citizendialogkitproject/citizen-dialog-kit/casing/CTA-large-background.pdf

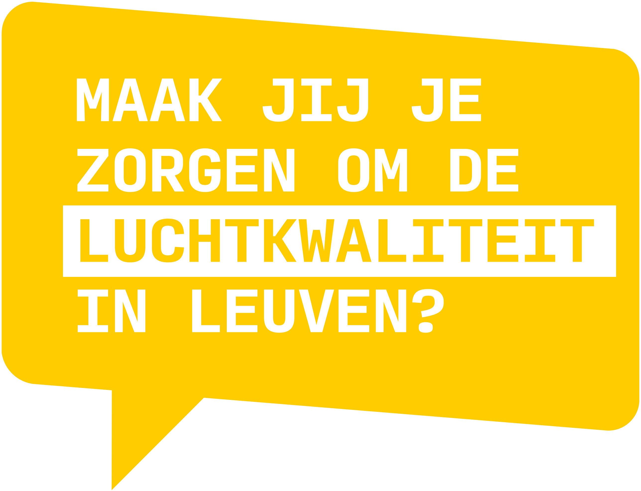
[picture p1: figure]
MAAK JIJ JE ZORGEN OM DE LUCHTKWALITEIT IN LEUVEN?
