citizendialogkitproject/citizen-dialog-kit/server/web/www/design/images/blank.png

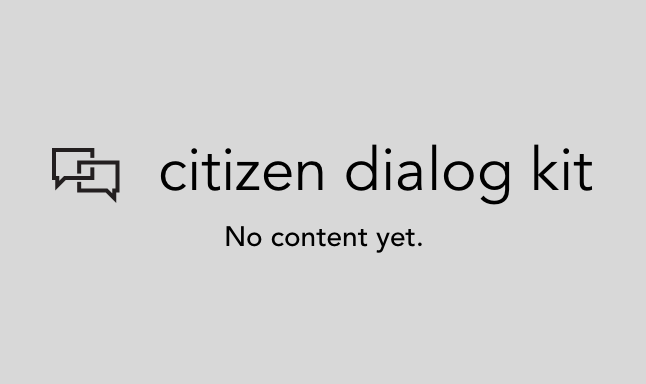
server/web/www/design/images/blank.png
