citizendialogkitproject/citizen-dialog-kit/server/web/www/design/images/rect1.png

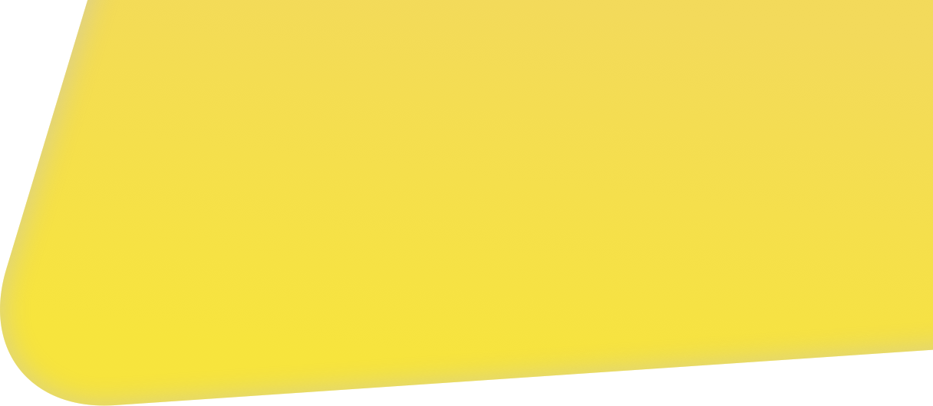
server/web/www/design/images/rect1.png
