citizendialogkitproject/citizen-dialog-kit/server/tests/data/test_640x384.png

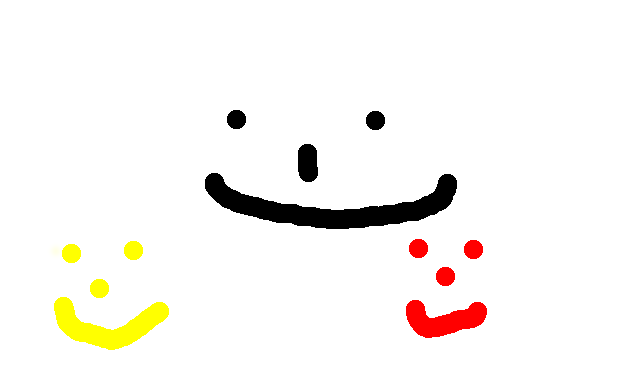
server/tests/data/test_640x384.png
