citizendialogkitproject/citizen-dialog-kit/casing/data-background.pdf

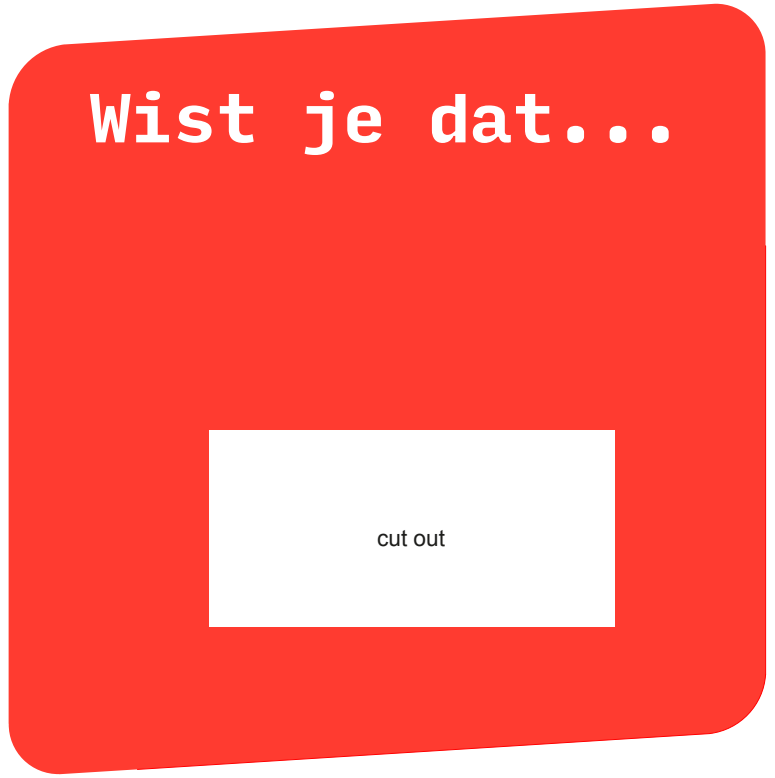
[picture p5: page 1]
cut out

Wist je dat...
