citizendialogkitproject/citizen-dialog-kit/casing/CTA-small-background.pdf

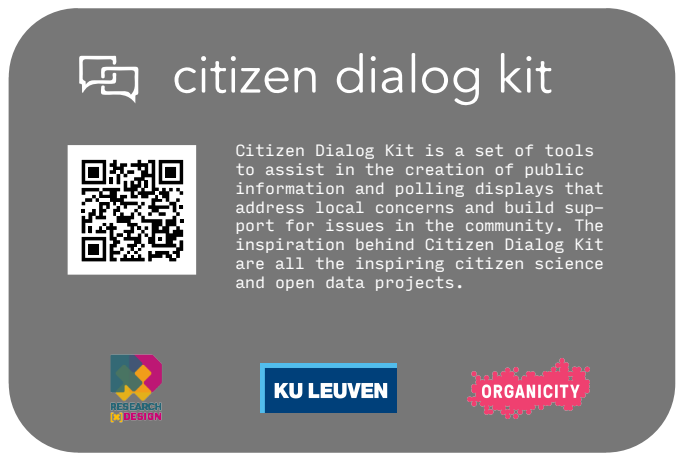
[picture p6: page 1]

Citizen Dialog Kit is a set of tools
to assist in the creation of public
information and polling displays that
address local concerns and build sup-
port for issues in the community. The
inspiration behind Citizen Dialog Kit
are all the inspiring citizen science
and open data projects.
