citizendialogkitproject/citizen-dialog-kit/casing/interactive-background.pdf

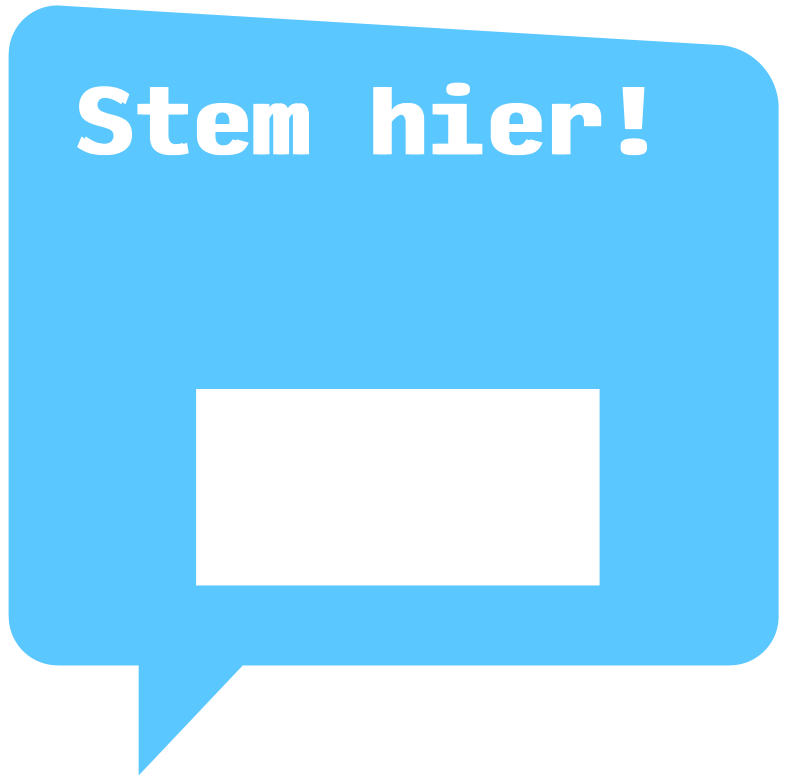
[picture p7: page 1]

Stem hier!
