citizendialogkitproject/citizen-dialog-kit/casing/plexi_layers6-Background8mm.pdf

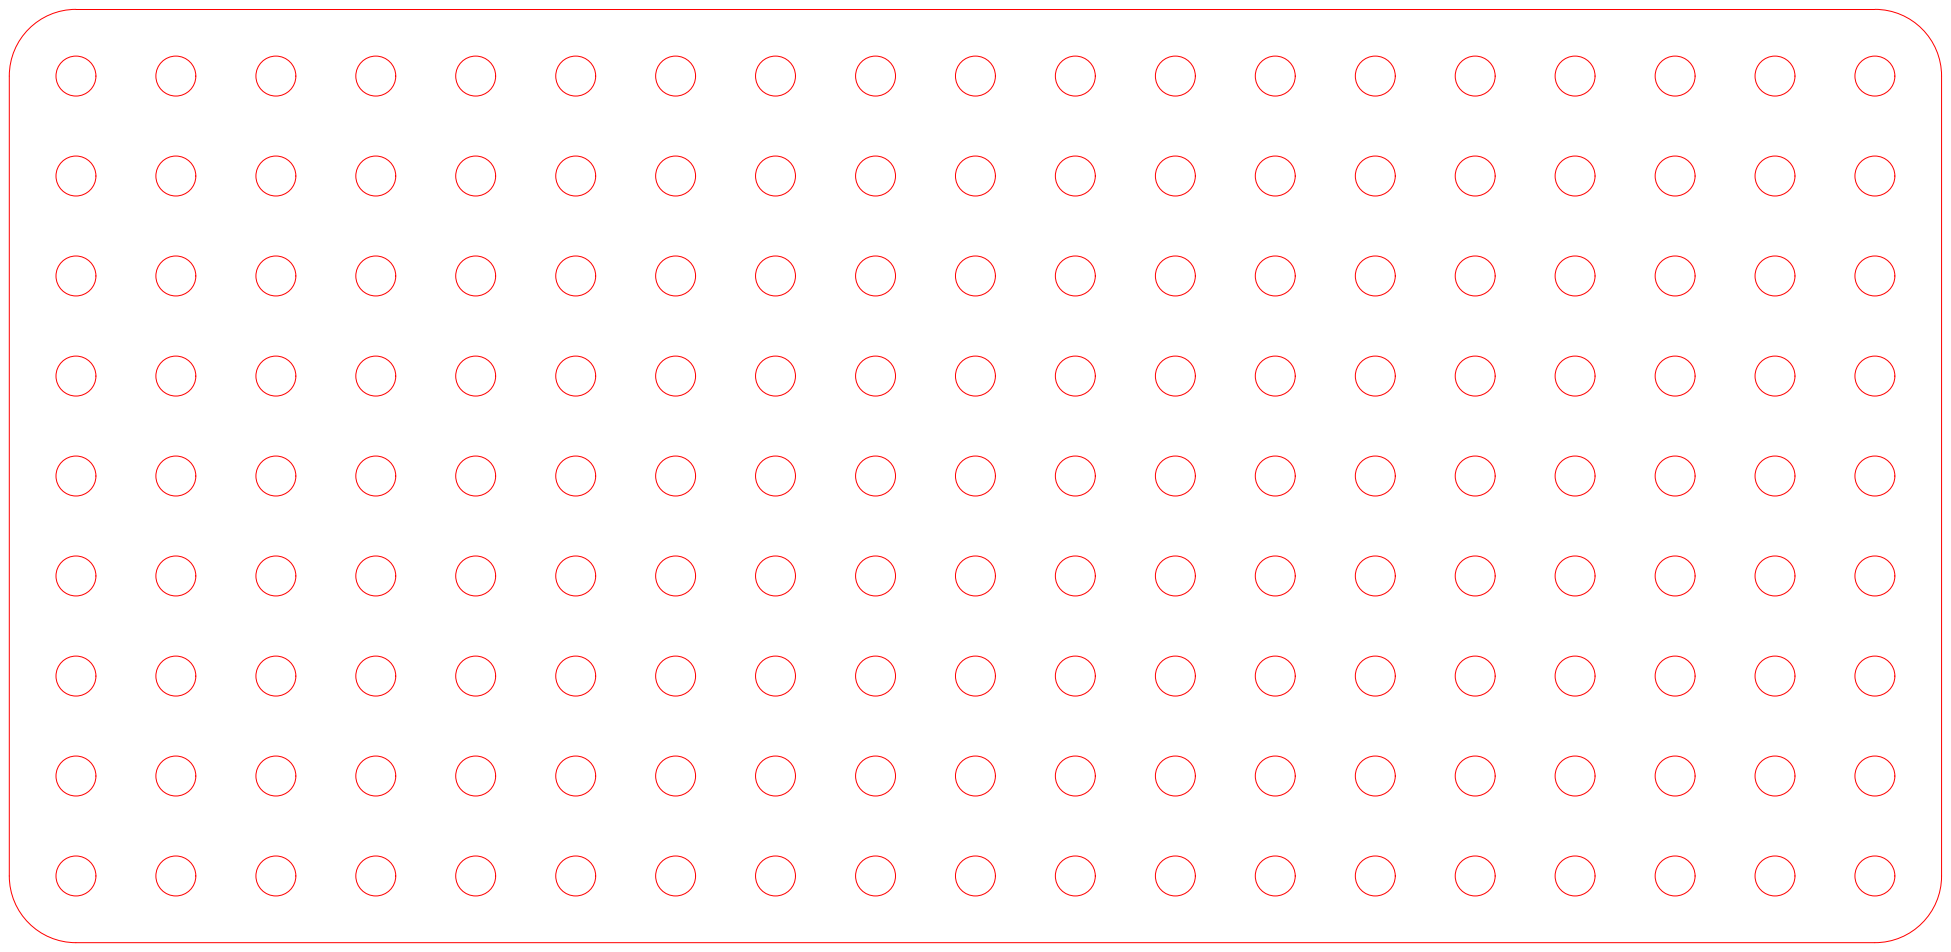
[picture p8: page 1]
