citizendialogkitproject/citizen-dialog-kit/casing/plexi_layers6-CTA2mm.pdf

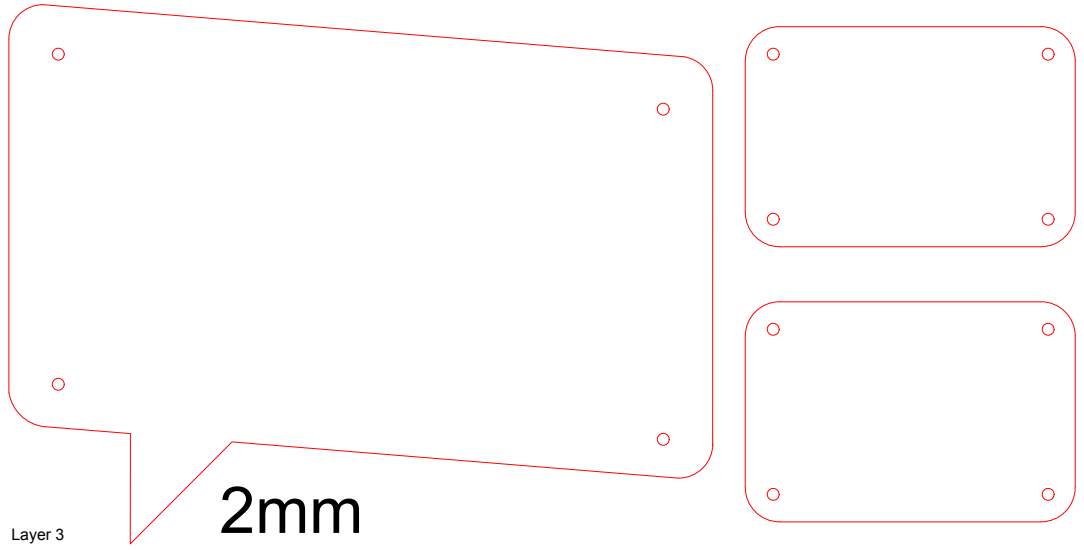
[picture p9: page 1]
Layer 3
