citizendialogkitproject/citizen-dialog-kit/casing/plexi_layers6-CTA2mmExtra.pdf

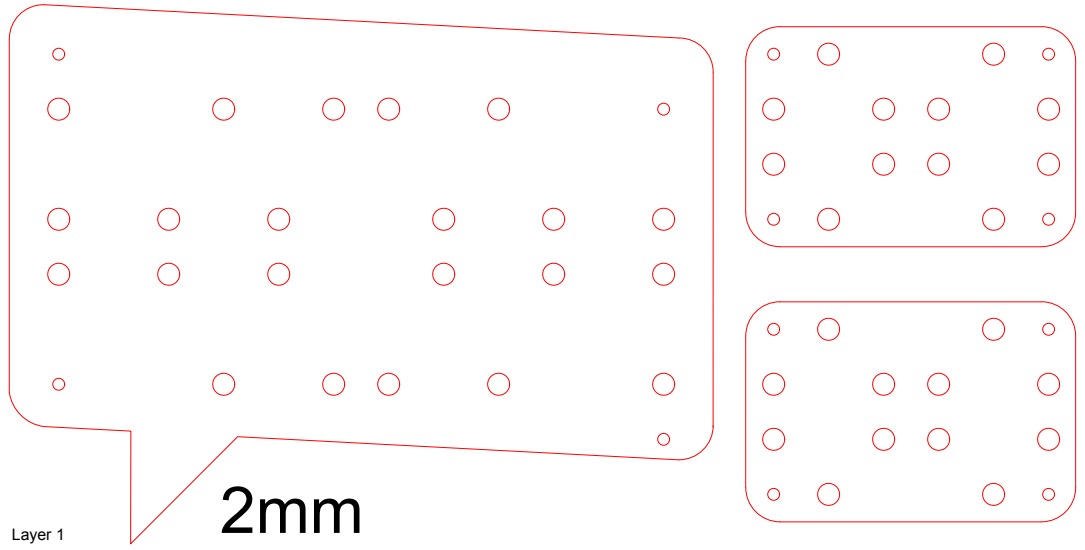
[picture p10: page 1]
Layer 1
