citizendialogkitproject/citizen-dialog-kit/casing/plexi_layers6-CTA8mm.pdf

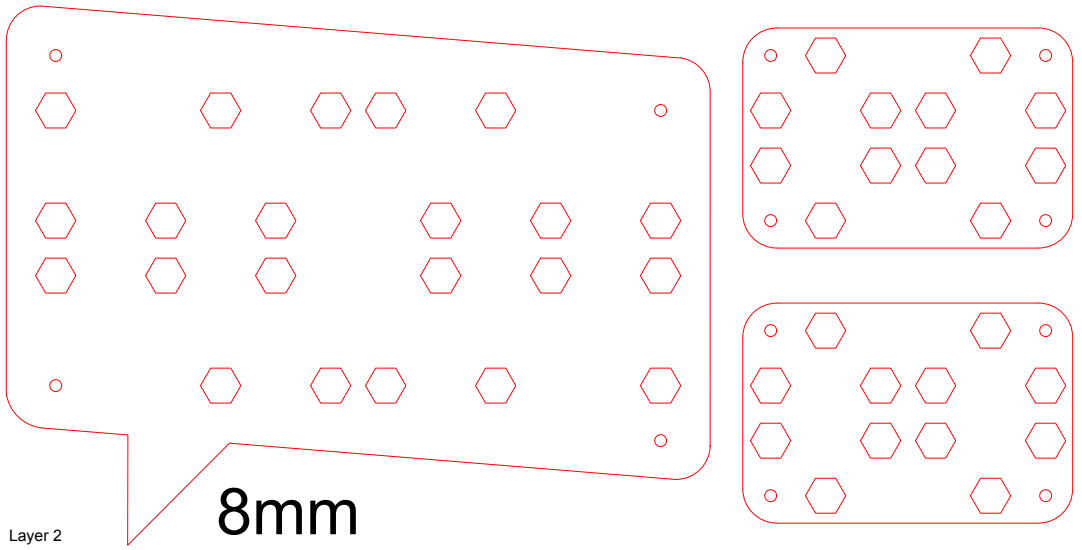
[picture p11: page 1]
Layer 2
