citizendialogkitproject/citizen-dialog-kit/casing/plexi_layers6-data2mm.pdf

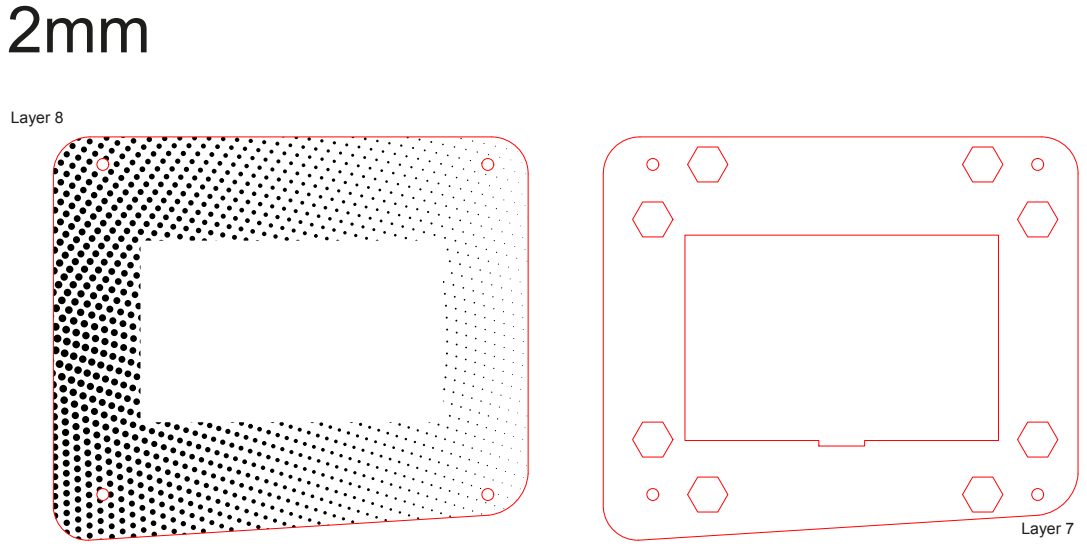
[picture p12: page 1]
Layer 7; Layer 8
