citizendialogkitproject/citizen-dialog-kit/casing/plexi_layers6-data2mm2.pdf

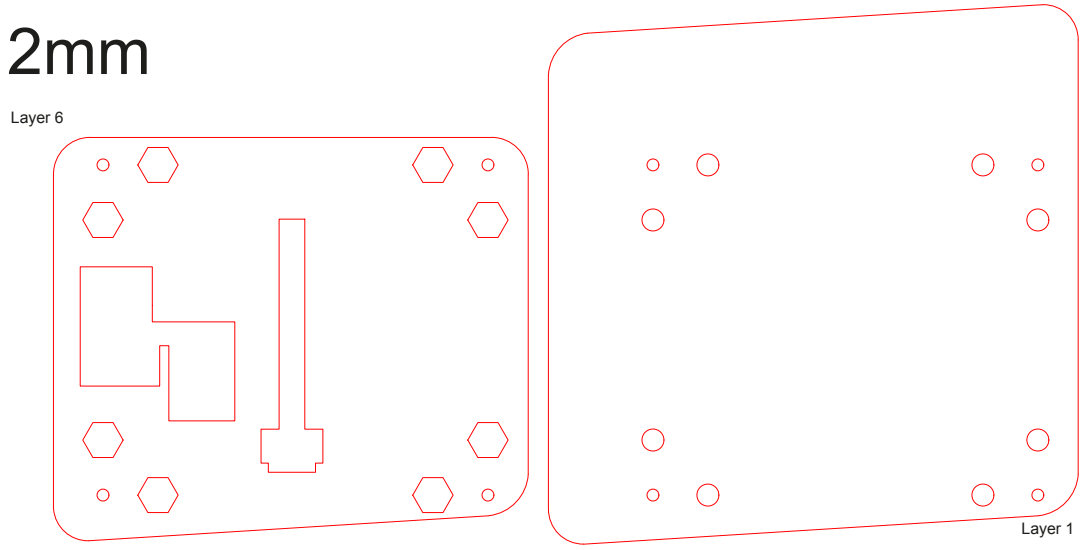
[picture p13: page 1]
Layer 1; Layer 6
