citizendialogkitproject/citizen-dialog-kit/casing/plexi_layers6-data6mm.pdf

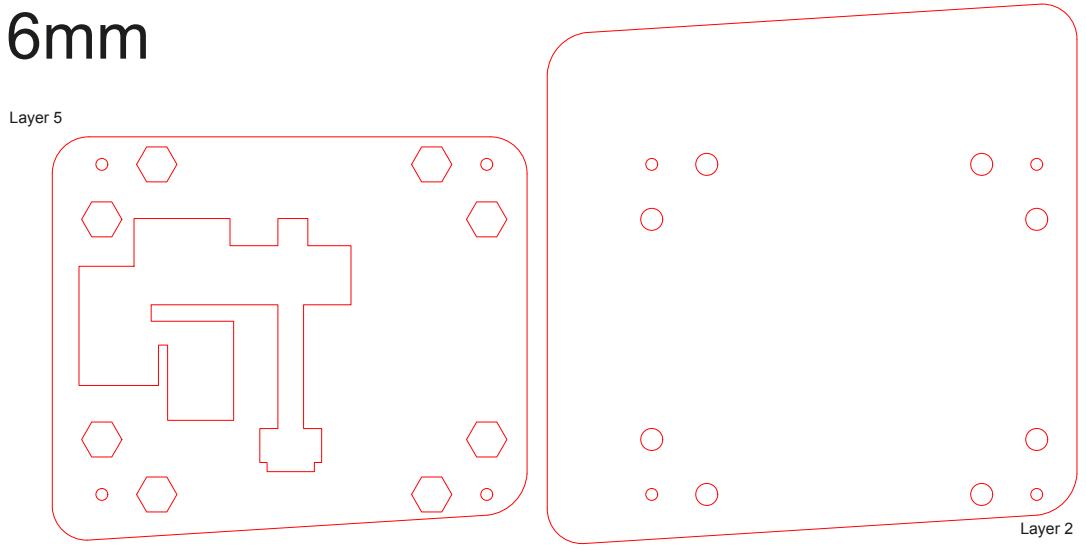
[picture p14: page 1]
Layer 2; Layer 5
