citizendialogkitproject/citizen-dialog-kit/casing/plexi_layers6-data8mm.pdf

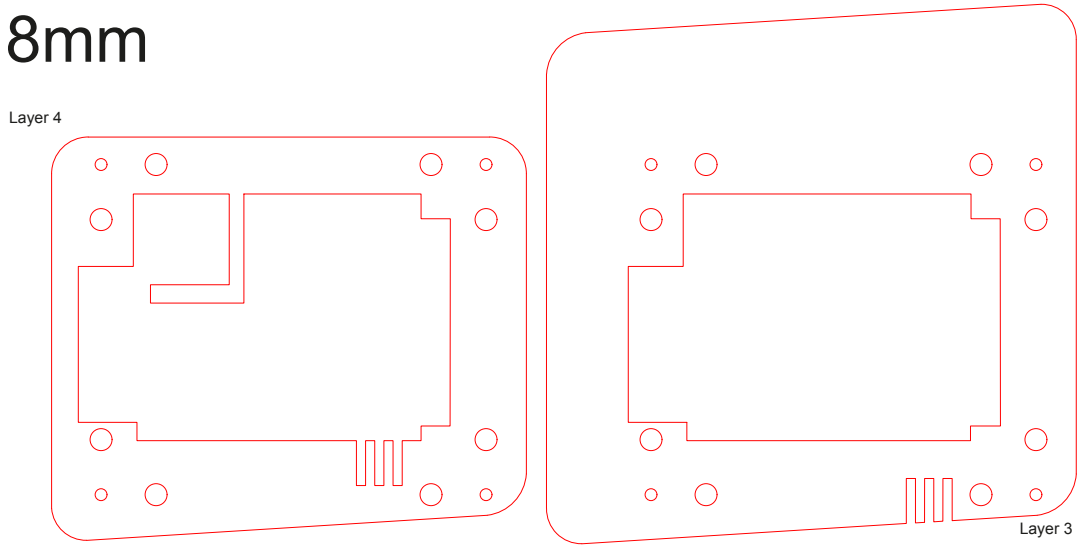
[picture p15: page 1]
Layer 3; Layer 4
