citizendialogkitproject/citizen-dialog-kit/casing/plexi_layers6-interactive2mm.pdf

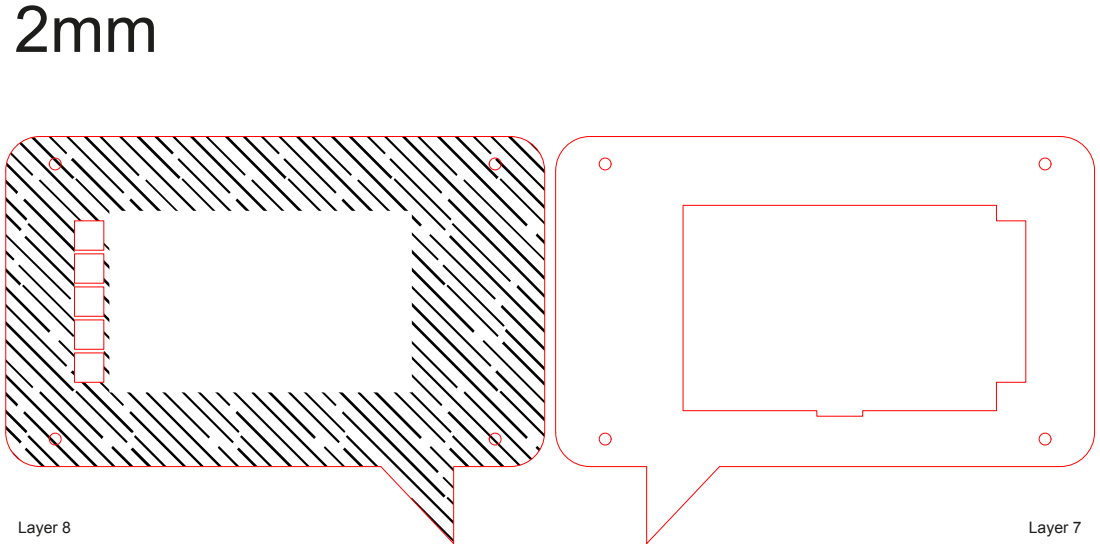
[picture p16: page 1]
Layer 8; Layer 7
