citizendialogkitproject/citizen-dialog-kit/casing/plexi_layers6-interactive2mm2.pdf

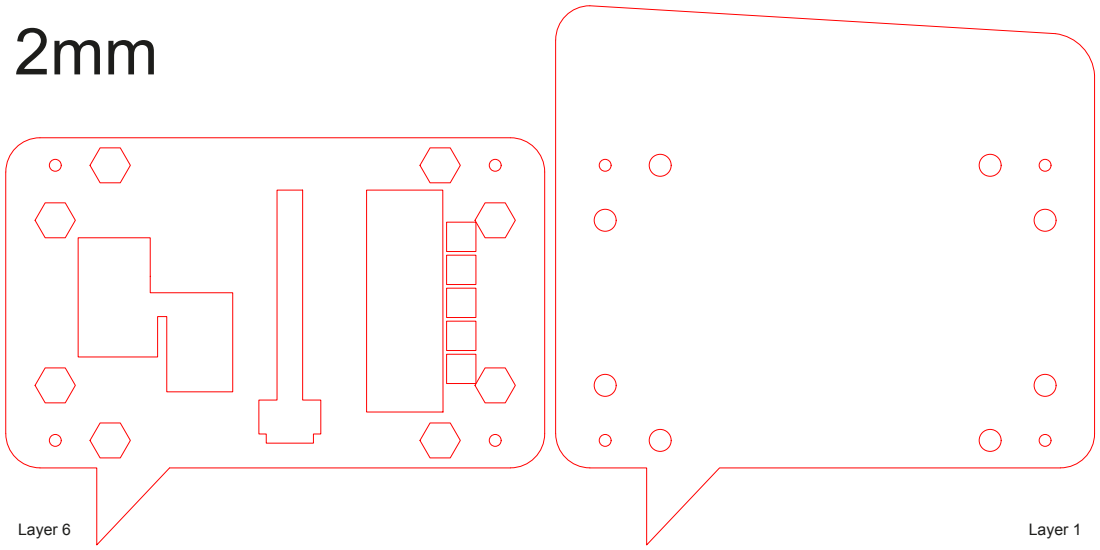
[picture p17: page 1]
Layer 6; Layer 1
