citizendialogkitproject/citizen-dialog-kit/casing/plexi_layers6-interactive6mm.pdf

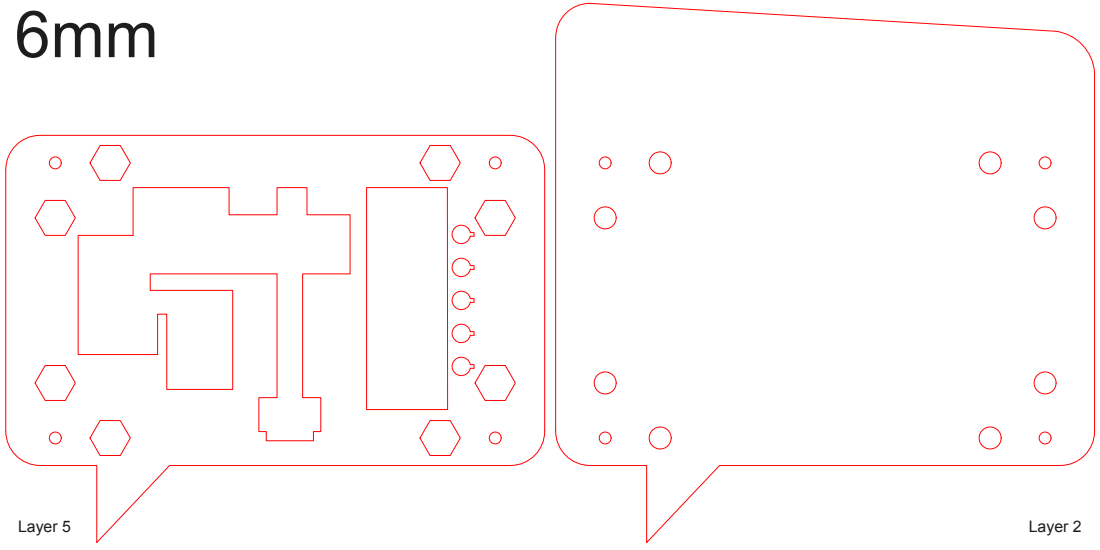
[picture p18: page 1]
Layer 5; Layer 2
