citizendialogkitproject/citizen-dialog-kit/casing/plexi_layers6-interactive8mm.pdf

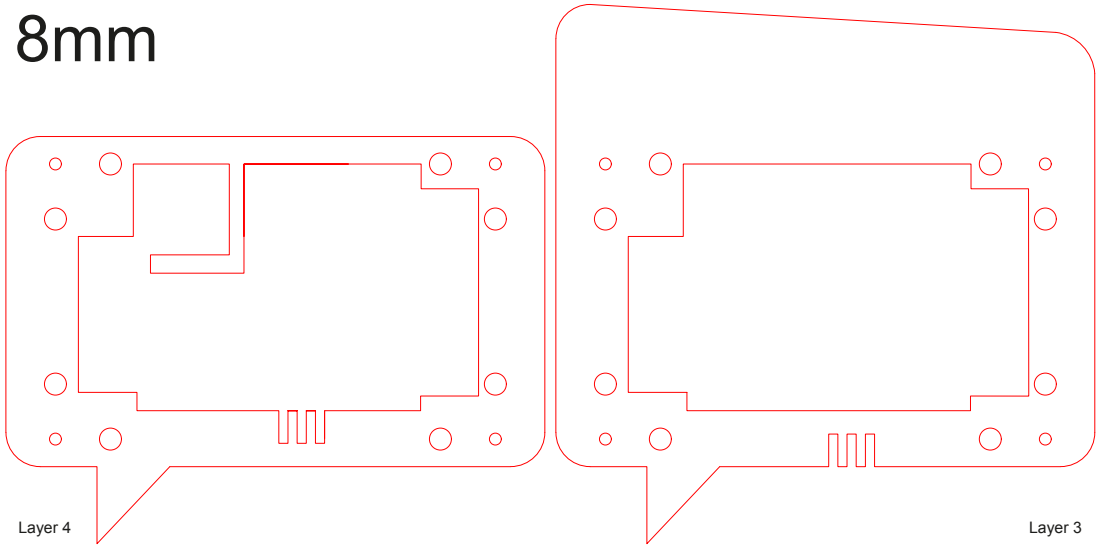
[picture p19: page 1]
Layer 4; Layer 3
