citizendialogkitproject/citizen-dialog-kit/(commit log)

2018-03-26 scheduling backend support for devices, testscript to match
2018-04-06 de-unique-ify image names
2018-04-09 fix for display alignment
    [kul-eink.ino]
2018-04-30 Added files to lasercut casing.
